mikolajklakulak-bit/Kontroler-lotu/kontroler_lotu.kicad_pcb

## KiCad design kontroler_lotu.kicad_pcb (2026-04-21)

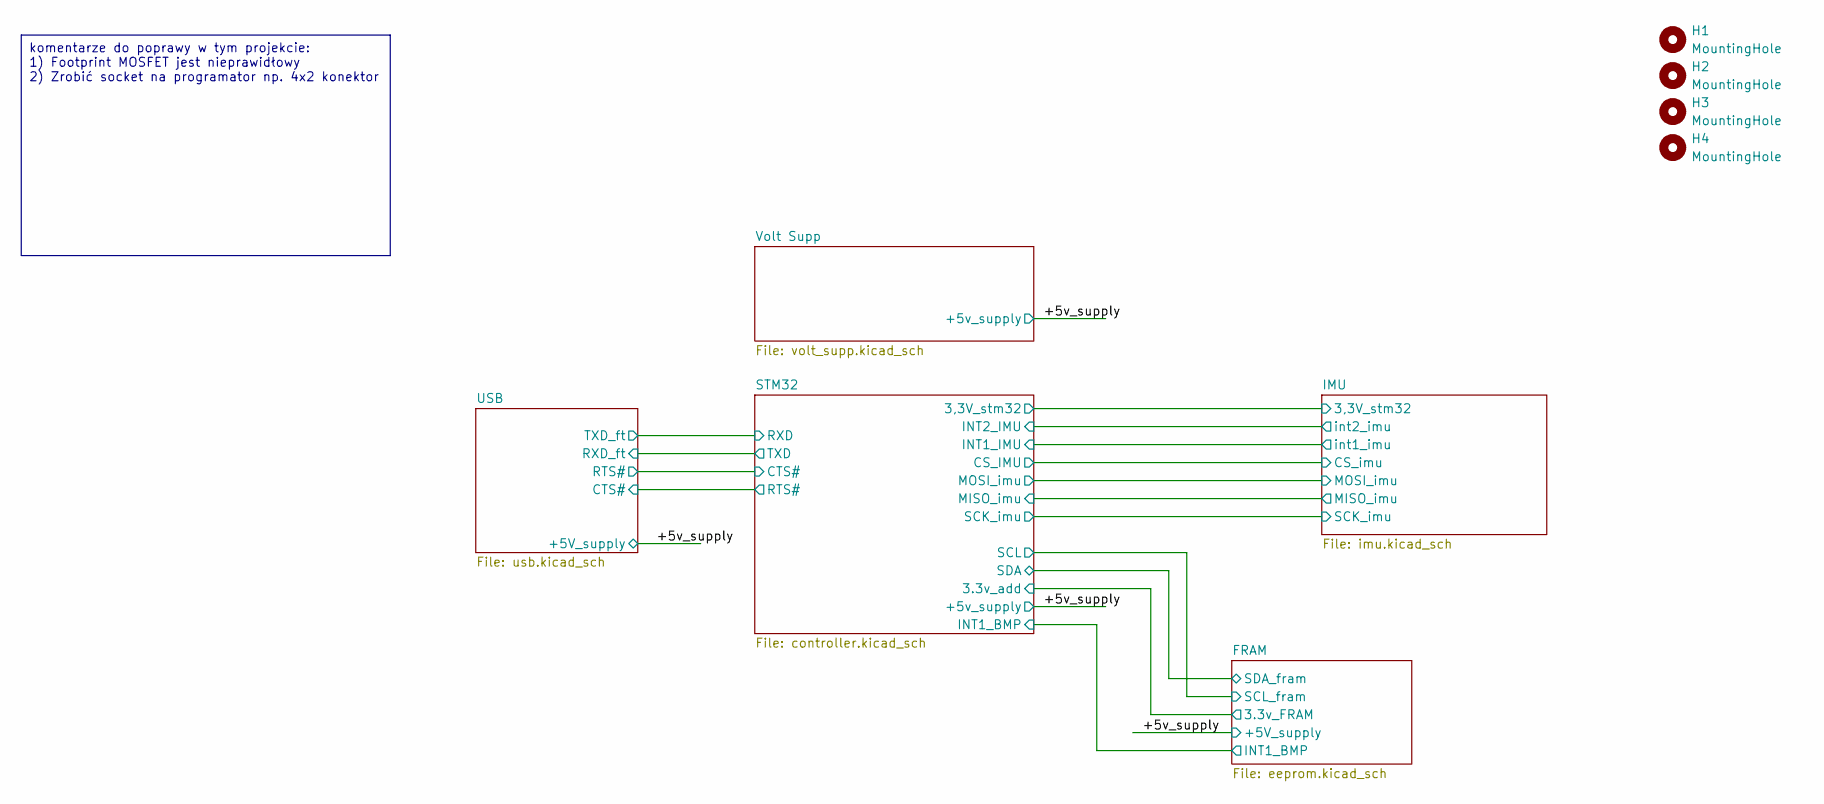
[picture p1: schematic kontroler_lotu.kicad_sch, Kontroler Lotu]

Parts:
H1, H2, H3, H4: MountingHole; MountingHole_3.2mm_M3_Pad

Notes on the sheet:
komentarze do poprawy w tym projekcie: 1) Footprint MOSFET jest nieprawidłowy 2) Zrobić socket na programator np. 4x2 konektor

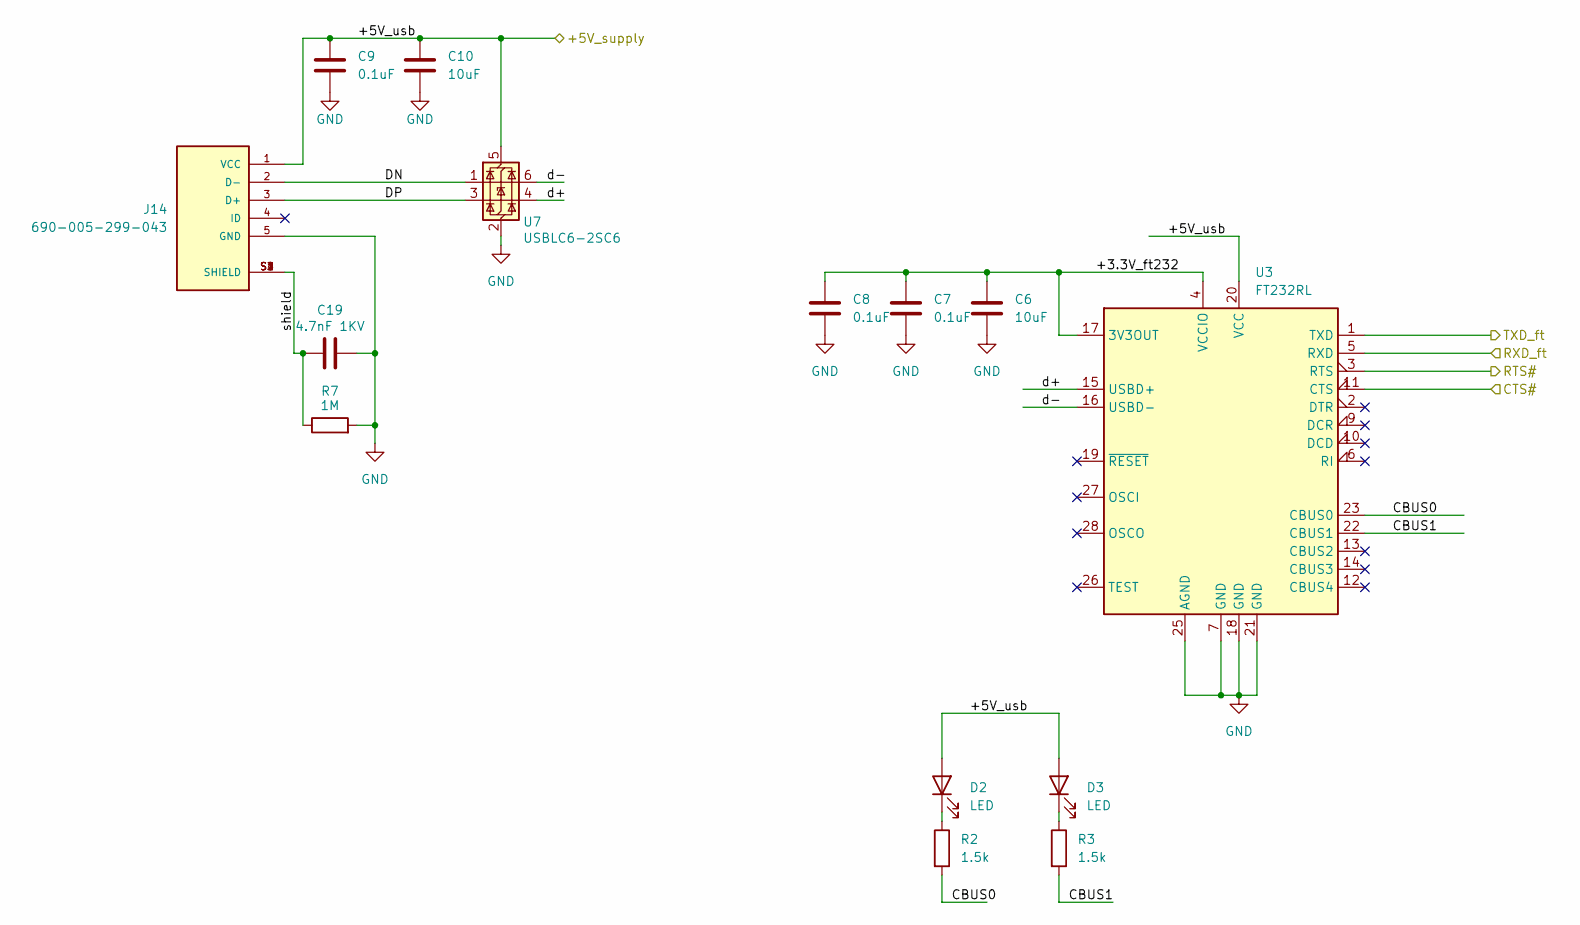
[picture p2: schematic usb.kicad_sch, Kontroler Lotu]

Parts:
C6, C10: 10uF; C_1206_3216Metric
C7, C8, C9: 0.1uF; C_0603_1608Metric
C19: 4.7nF 1KV; C_1210_3225Metric
D2, D3: LED; LED_0805_2012Metric
J14: 690-005-299-043; 690005299043; PARTREV 11; DigiKey_Part_Number 151-1206-2-ND
R2, R3: 1.5k; R_0603_1608Metric
R7: 1M; R_2512_6332Metric
U3: FT232RL; SSOP-28_5.3x10.2mm_P0.65mm
U7: USBLC6-2SC6; SOT-23-6

Connections:
/+5v_supply: C9.1, C10.1, D2.2 (A), D3.2 (A), J14.1 (VCC), U3.20 (VCC), U7.5 (VBUS); also elsewhere on the board
/STM32/CTS#: U3.3 (RTS); also elsewhere on the board
/STM32/RTS#: U3.11 (CTS); also elsewhere on the board
/STM32/RXD: U3.1 (TXD); also elsewhere on the board
/STM32/TXD: U3.5 (RXD); also elsewhere on the board
/USB/+3.3V_ft232: C6.1, C7.1, C8.1, U3.4 (VCCIO), U3.17 (3V3OUT)
/USB/CBUS0: R2.2, U3.23 (CBUS0)
/USB/CBUS1: R3.2, U3.22 (CBUS1)
/USB/DN: J14.2 (D-), U7.1 (I/O1)
/USB/DP: J14.3 (D+), U7.3 (I/O2)
/USB/d+: U3.15 (USBD+), U7.4 (I/O2)
/USB/d-: U3.16 (USBD-), U7.6 (I/O1)
/USB/shield: C19.1, J14.S1 (SHIELD), J14.S2 (SHIELD), J14.S3 (SHIELD), J14.S4 (SHIELD), R7.1
GND: C6.2, C7.2, C8.2, C9.2, C10.2, C19.2, J14.5 (GND), R7.2, U3.7 (GND), U3.18 (GND), U3.21 (GND), U3.25 (AGND), U7.2 (GND); also elsewhere on the board
unnamed: D2.1 (K), R2.1
unnamed: D3.1 (K), R3.1

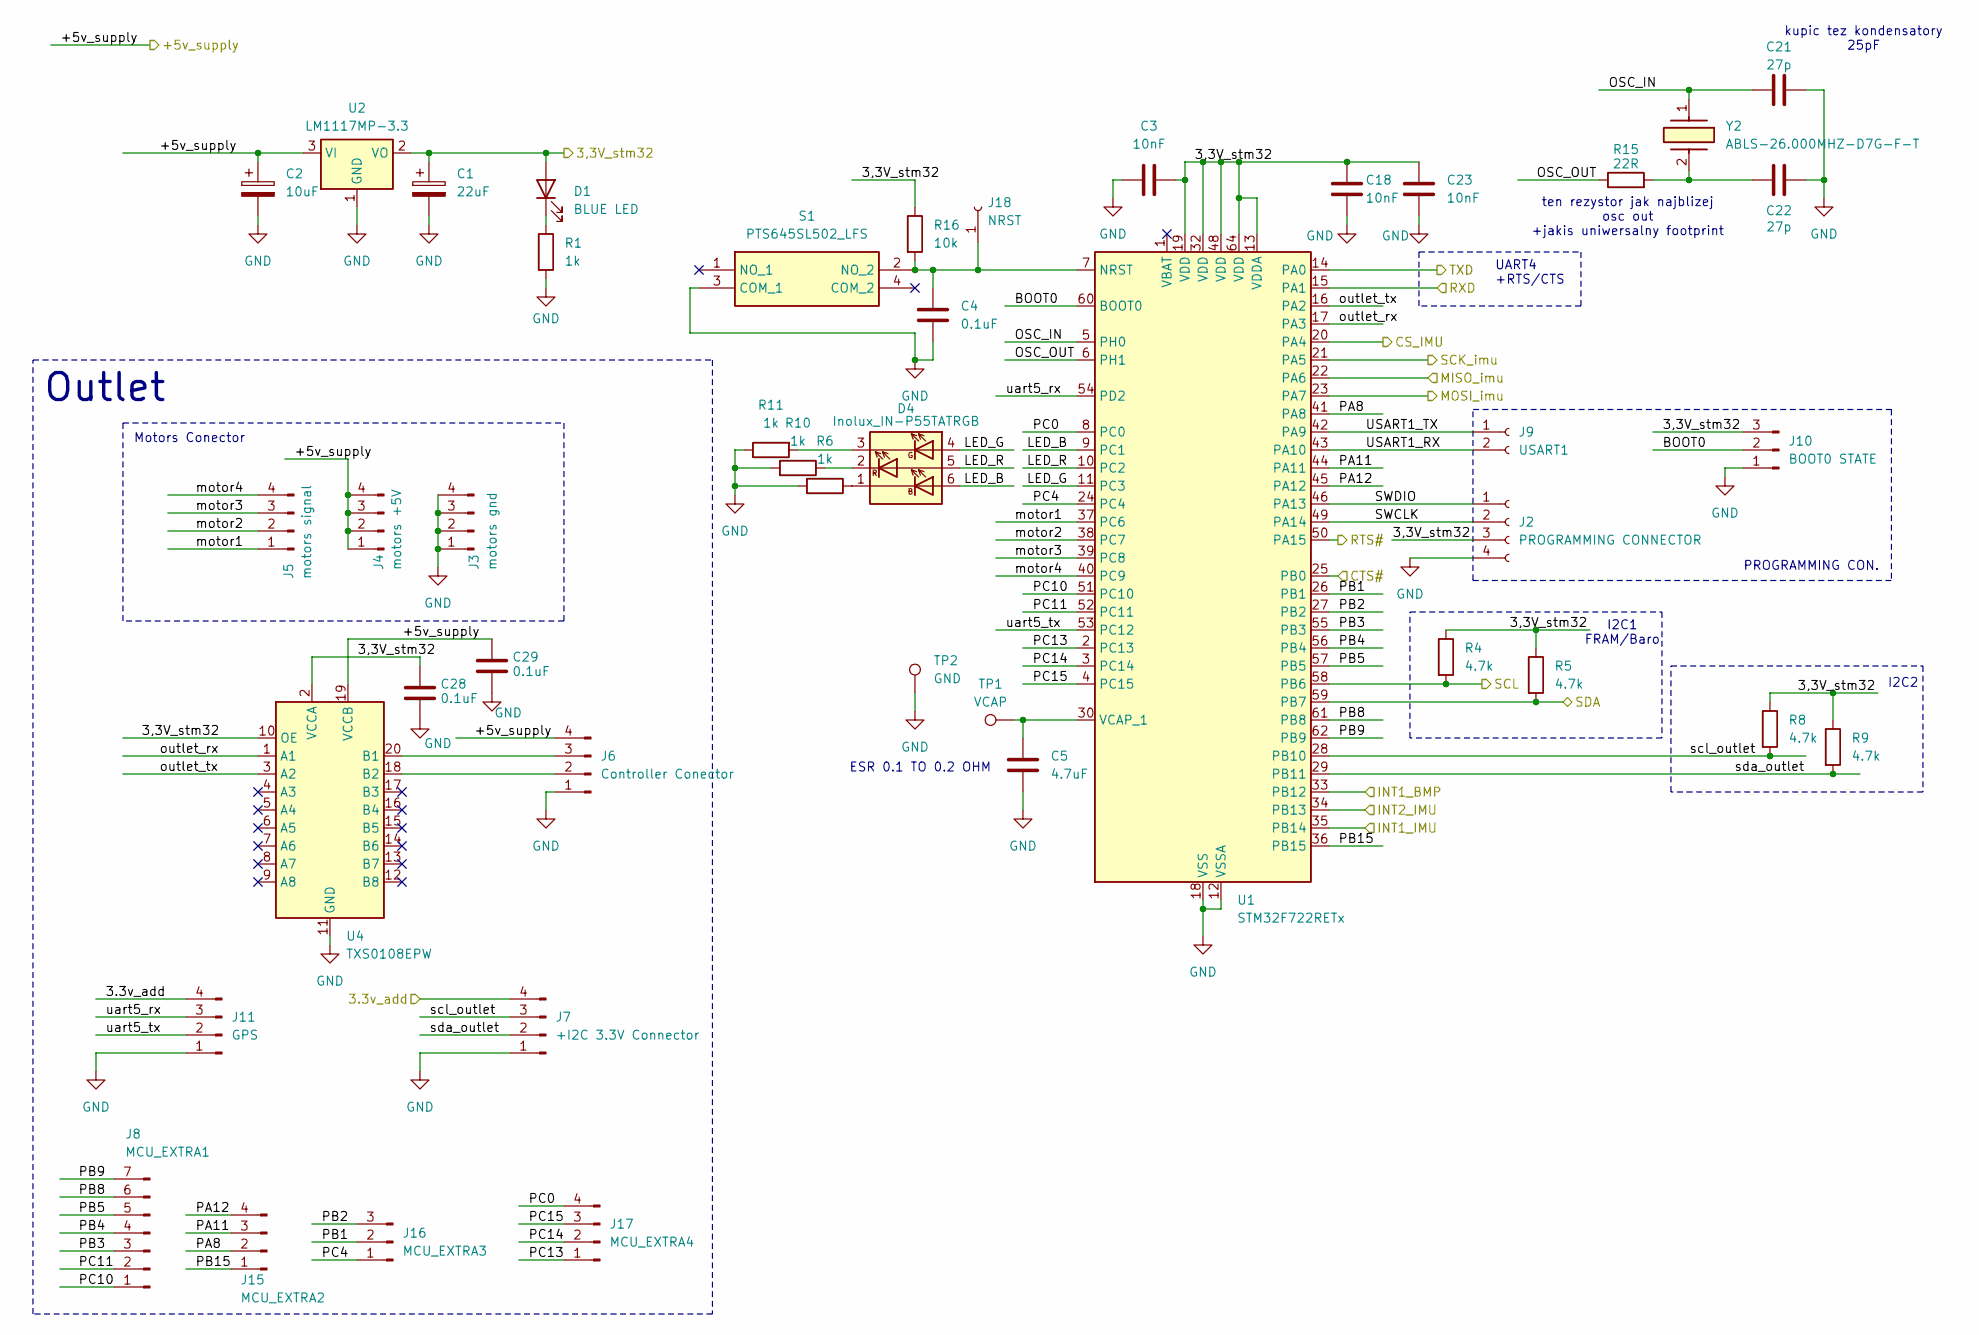
[picture p3: schematic controller.kicad_sch, Kontroler Lotu]

Parts:
C1: 22uF; CP_EIA-3528-12_Kemet-T
C2: 10uF; C_1206_3216Metric
C3, C18, C23: 10nF; C_0603_1608Metric
C4, C28, C29: 0.1uF; C_0603_1608Metric
C5: 4.7uF; C_0603_1608Metric
C21, C22: 27p; C_0603_1608Metric
D1: BLUE LED; LED_0805_2012Metric
D4: Inolux_IN-P55TATRGB; LED_Inolux_IN-P55TATRGB_PLCC6_5.0x5.5mm_P1.8mm
J2: PROGRAMMING CONNECTOR; PinHeader_1x04_P2.54mm_Vertical
J3: motors gnd; PinHeader_1x04_P2.54mm_Vertical
J4: motors +5V; PinHeader_1x04_P2.54mm_Vertical
J5: motors signal; PinHeader_1x04_P2.54mm_Vertical
J6: Controller Conector; PinHeader_1x04_P2.54mm_Vertical
J7: +I2C 3.3V Connector; PinHeader_1x04_P2.54mm_Vertical
J8: MCU_EXTRA1; PinHeader_1x07_P2.54mm_Vertical
J9: USART1; PinHeader_1x02_P2.54mm_Vertical
J10: BOOT0 STATE; PinHeader_1x03_P2.54mm_Vertical
J11: GPS; PinHeader_1x04_P2.54mm_Vertical
J15: MCU_EXTRA2; PinHeader_1x04_P2.54mm_Vertical
J16: MCU_EXTRA3; PinHeader_1x03_P2.54mm_Vertical
J17: MCU_EXTRA4; PinHeader_1x04_P2.54mm_Vertical
J18: NRST; PinHeader_1x01_P2.54mm_Vertical
R1, R6, R10, R11: 1k; R_0603_1608Metric
R4, R5, R8, R9: 4.7k; R_0603_1608Metric
R15: 22R; R_0603_1608Metric
R16: 10k; R_0603_1608Metric
S1: PTS645SL502_LFS; PTS645SL502LFS; Manufacturer_Part_Number PTS645SL502 LFS
TP1: VCAP; TestPoint_Keystone_5015_Micro-Minature
TP2: GND; TestPoint_Keystone_5015_Micro-Minature
U1: STM32F722RETx; LQFP-64_10x10mm_P0.5mm
U2: LM1117MP-3.3; SOT-223-3_TabPin2
U4: TXS0108EPW; TSSOP-20_4.4x6.5mm_P0.65mm
Y2: ABLS-26.000MHZ-D7G-F-T; ABLS; Manufacturer_Part_Number ABLS-26.000MHZ-D7G-F-T

Connections:
/+5v_supply: C2.1, C29.1, J4.1, J4.2, J4.3, J4.4, J6.4, U2.3 (VI), U4.19 (VCCB); also elsewhere on the board
/FRAM/3,3V_fram: J7.4, J11.4; also elsewhere on the board
/FRAM/INT1_BMP: U1.33 (PB12); also elsewhere on the board
/FRAM/SCL_fram: R4.2, U1.58 (PB6); also elsewhere on the board
/FRAM/SDA_fram: R5.2, U1.59 (PB7); also elsewhere on the board
/IMU/3,3V_imu: C1.1, C3.2, C18.2, C23.2, C28.1, D1.2 (A), J2.3, J10.3, R4.1, R5.1, R8.1, R9.1, R16.1, U1.13 (VDDA), U1.19 (VDD), U1.32 (VDD), U1.48 (VDD), U1.64 (VDD), U2.2 (VO), U4.2 (VCCA), U4.10 (OE); also elsewhere on the board
/IMU/CS_imu: U1.20 (PA4); also elsewhere on the board
/IMU/MISO_imu: U1.22 (PA6); also elsewhere on the board
/IMU/MOSI_imu: U1.23 (PA7); also elsewhere on the board
/IMU/SCK_imu: U1.21 (PA5); also elsewhere on the board
/IMU/int1_imu: U1.35 (PB14); also elsewhere on the board
/IMU/int2_imu: U1.34 (PB13); also elsewhere on the board
/STM32/BOOT0: J10.2, U1.60 (BOOT0)
/STM32/CTS#: U1.25 (PB0); also elsewhere on the board
/STM32/LED_B: D4.6 (AB), U1.9 (PC1)
/STM32/LED_G: D4.4 (AG), U1.11 (PC3)
/STM32/LED_R: D4.5 (AR), U1.10 (PC2)
/STM32/OSC_IN: C21.1, U1.5 (PH0), Y2.1
/STM32/OSC_OUT: R15.1, U1.6 (PH1)
/STM32/PA8: J15.2, U1.41 (PA8)
/STM32/PA11: J15.3, U1.44 (PA11)
/STM32/PA12: J15.4, U1.45 (PA12)
/STM32/PB1: J16.2, U1.26 (PB1)
/STM32/PB2: J16.3, U1.27 (PB2)
/STM32/PB3: J8.3, U1.55 (PB3)
/STM32/PB4: J8.4, U1.56 (PB4)
/STM32/PB5: J8.5, U1.57 (PB5)
/STM32/PB8: J8.6, U1.61 (PB8)
/STM32/PB9: J8.7, U1.62 (PB9)
/STM32/PB15: J15.1, U1.36 (PB15)
/STM32/PC0: J17.4, U1.8 (PC0)
/STM32/PC4: J16.1, U1.24 (PC4)
/STM32/PC10: J8.1, U1.51 (PC10)
/STM32/PC11: J8.2, U1.52 (PC11)
/STM32/PC13: J17.1, U1.2 (PC13)
/STM32/PC14: J17.2, U1.3 (PC14)
/STM32/PC15: J17.3, U1.4 (PC15)
/STM32/RTS#: U1.50 (PA15); also elsewhere on the board
/STM32/RXD: U1.15 (PA1); also elsewhere on the board
/STM32/SWCLK: J2.2, U1.49 (PA14)
/STM32/SWDIO: J2.1, U1.46 (PA13)
/STM32/TXD: U1.14 (PA0); also elsewhere on the board
/STM32/USART1_RX: J9.2, U1.43 (PA10)
/STM32/USART1_TX: J9.1, U1.42 (PA9)
/STM32/motor1: J5.1, U1.37 (PC6)
/STM32/motor2: J5.2, U1.38 (PC7)
/STM32/motor3: J5.3, U1.39 (PC8)
/STM32/motor4: J5.4, U1.40 (PC9)
/STM32/outlet_rx: U1.17 (PA3), U4.1 (A1)
/STM32/outlet_tx: U1.16 (PA2), U4.3 (A2)
/STM32/scl_outlet: J7.3, R8.2, U1.28 (PB10)
/STM32/sda_outlet: J7.2, R9.2, U1.29 (PB11)
/STM32/uart5_rx: J11.3, U1.54 (PD2)
/STM32/uart5_tx: J11.2, U1.53 (PC12)
GND: C1.2, C2.2, C3.1, C4.2, C5.2, C18.1, C21.2, C22.2, C23.1, C28.2, C29.2, J2.4, J3.1, J3.2, J3.3, J3.4, J6.1, J7.1, J10.1, J11.1, R1.2, R6.2, R10.2, R11.1, S1.3 (COM_1), TP2.1, U1.12 (VSSA), U1.18 (VSS), U1.31 (VSS), U1.47 (VSS), U1.63 (VSS), U2.1 (GND), U4.11 (GND); also elsewhere on the board
unnamed: C22.1, R15.2, Y2.2
unnamed: D1.1 (K), R1.1
unnamed: D4.1 (KB), R6.1
unnamed: D4.3 (KG), R11.2
unnamed: D4.2 (KR), R10.1
unnamed: J6.2, U4.18 (B2)
unnamed: J6.3, U4.20 (B1)
unnamed: C4.1, J18.1, R16.2, S1.2 (NO_2), U1.7 (NRST)
unnamed: C5.1, TP1.1, U1.30 (VCAP_1)

Notes on the sheet:
UART4 +RTS/CTS
kupic tez kondensatory 25pF
ten rezystor jak najblizej osc out +jakis uniwersalny footprint
Outlet
PROGRAMMING CON.
I2C1 FRAM/Baro
Motors Conector
I2C2
ESR 0.1 TO 0.2 OHM

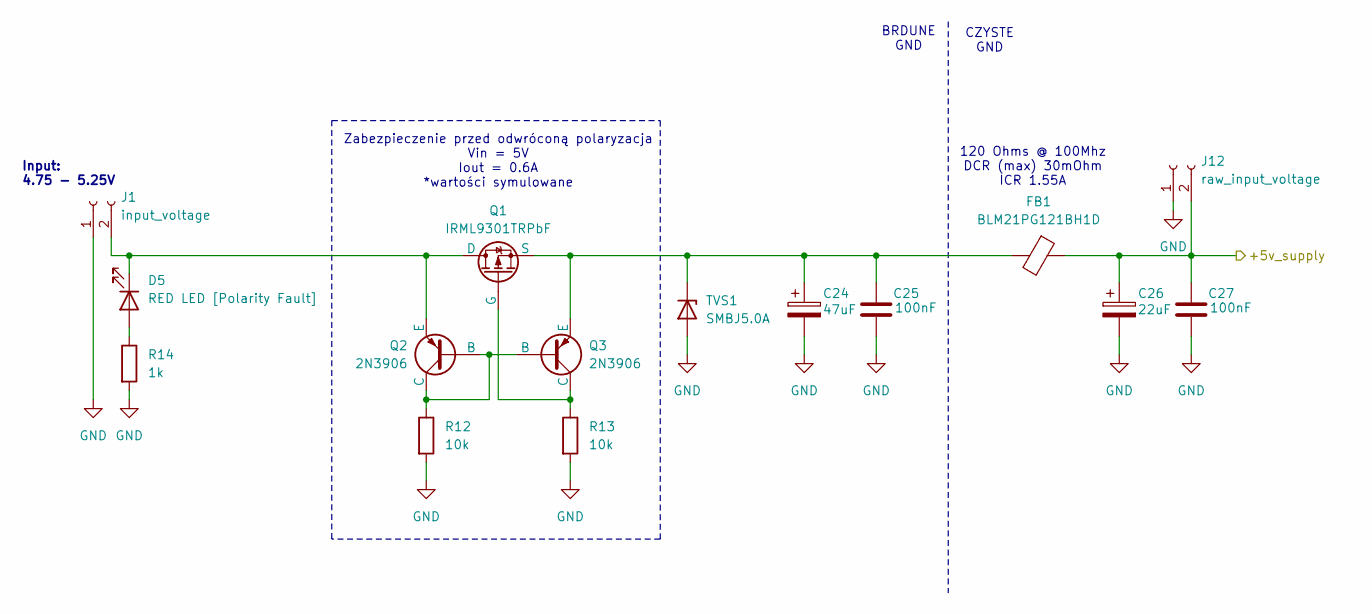
[picture p4: schematic volt_supp.kicad_sch, Kontroler Lotu]

Parts:
C24: 47uF; CP_EIA-3528-12_Kemet-T
C25, C27: 100nF; C_0603_1608Metric
C26: 22uF; CP_EIA-3528-12_Kemet-T
D5: RED LED [Polarity Fault]; LED_0805_2012Metric
FB1: BLM21PG121BH1D; L_0805_2012Metric_Pad1.15x1.40mm_HandSolder
J1: input_voltage; PinSocket_1x02_P2.54mm_Vertical
J12: raw_input_voltage; PinSocket_1x02_P2.54mm_Vertical
Q1: IRML9301TRPbF; SOT-23
Q2, Q3: 2N3906; TO-92L_Inline
R12, R13: 10k; R_0603_1608Metric
R14: 1k; R_0603_1608Metric
TVS1: SMBJ5.0A; D_SMB_Handsoldering

Connections:
/+5v_supply: C26.1, C27.1, FB1.1, J12.2; also elsewhere on the board
GND: C24.2, C25.2, C26.2, C27.2, J1.1, J12.1, R12.2, R13.2, R14.2, TVS1.2 (A); also elsewhere on the board
unnamed: D5.2 (A), R14.1
unnamed: D5.1 (K), J1.2, Q1.1 (D), Q2.3 (E)
unnamed: Q1.2 (G), Q3.1 (C), R13.1
unnamed: C24.1, C25.1, FB1.2, Q1.3 (S), Q3.3 (E), TVS1.1 (K)
unnamed: Q2.1 (C), Q2.2 (B), Q3.2 (B), R12.1

Notes on the sheet:
Zabezpieczenie przed odwróconą polaryzacja Vin = 5V Iout = 0.6A *wartości symulowane
CZYSTE GND
Input: 4.75 - 5.25V
BRDUNE GND
120 Ohms @ 100Mhz DCR (max) 30mOhm ICR 1.55A

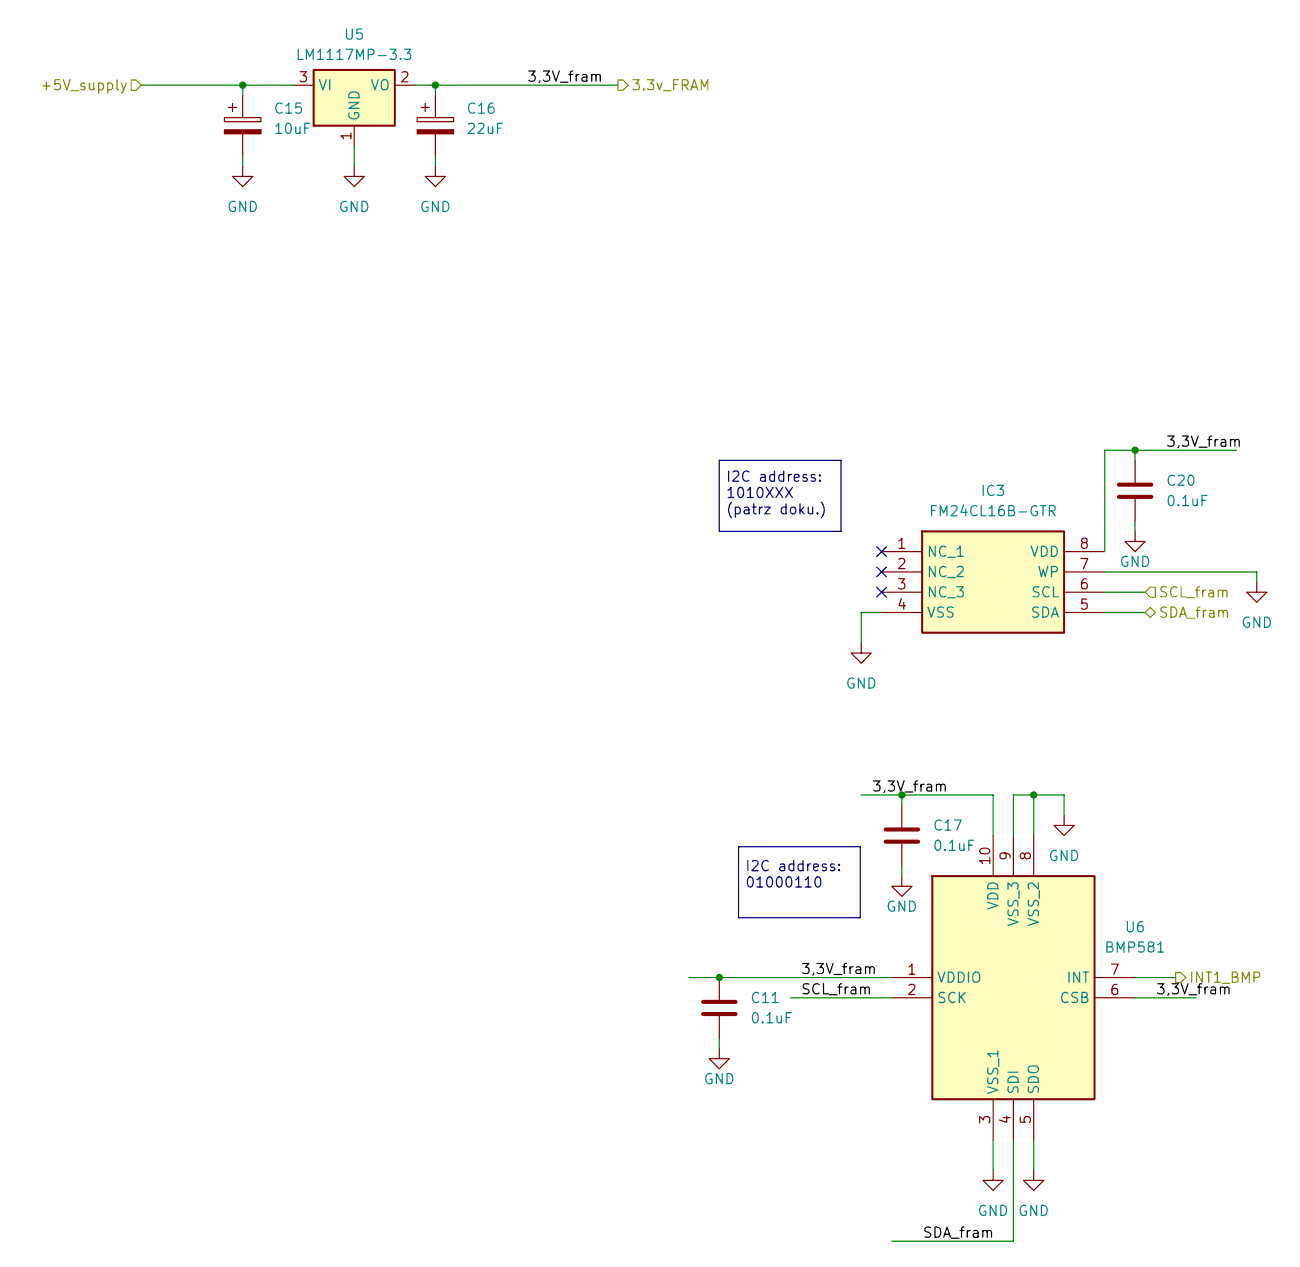
[picture p5: schematic eeprom.kicad_sch, Kontroler Lotu]

Parts:
C11, C17, C20: 0.1uF; C_0603_1608Metric
C15: 10uF; C_1206_3216Metric
C16: 22uF; CP_EIA-3528-12_Kemet-T
IC3: FM24CL16B-GTR; SOIC127P602X173-8N; Manufacturer_Part_Number FM24CL16B-GTR
U5: LM1117MP-3.3; SOT-223-3_TabPin2
U6: BMP581; Mouser Part Number 262-BMP581

Connections:
/+5v_supply: C15.1, U5.3 (VI); also elsewhere on the board
/FRAM/3,3V_fram: C11.1, C16.1, C17.1, C20.1, IC3.8 (VDD), U5.2 (VO), U6.1 (VDDIO), U6.6 (CSB), U6.10 (VDD); also elsewhere on the board
/FRAM/INT1_BMP: U6.7 (INT); also elsewhere on the board
/FRAM/SCL_fram: IC3.6 (SCL), U6.2 (SCK); also elsewhere on the board
/FRAM/SDA_fram: IC3.5 (SDA), U6.4 (SDI); also elsewhere on the board
GND: C11.2, C15.2, C16.2, C17.2, C20.2, IC3.4 (VSS), IC3.7 (WP), U5.1 (GND), U6.3 (VSS_1), U6.5 (SDO), U6.8 (VSS_2), U6.9 (VSS_3); also elsewhere on the board

Notes on the sheet:
I2C address: 01000110
I2C address: 1010XXX (patrz doku.)

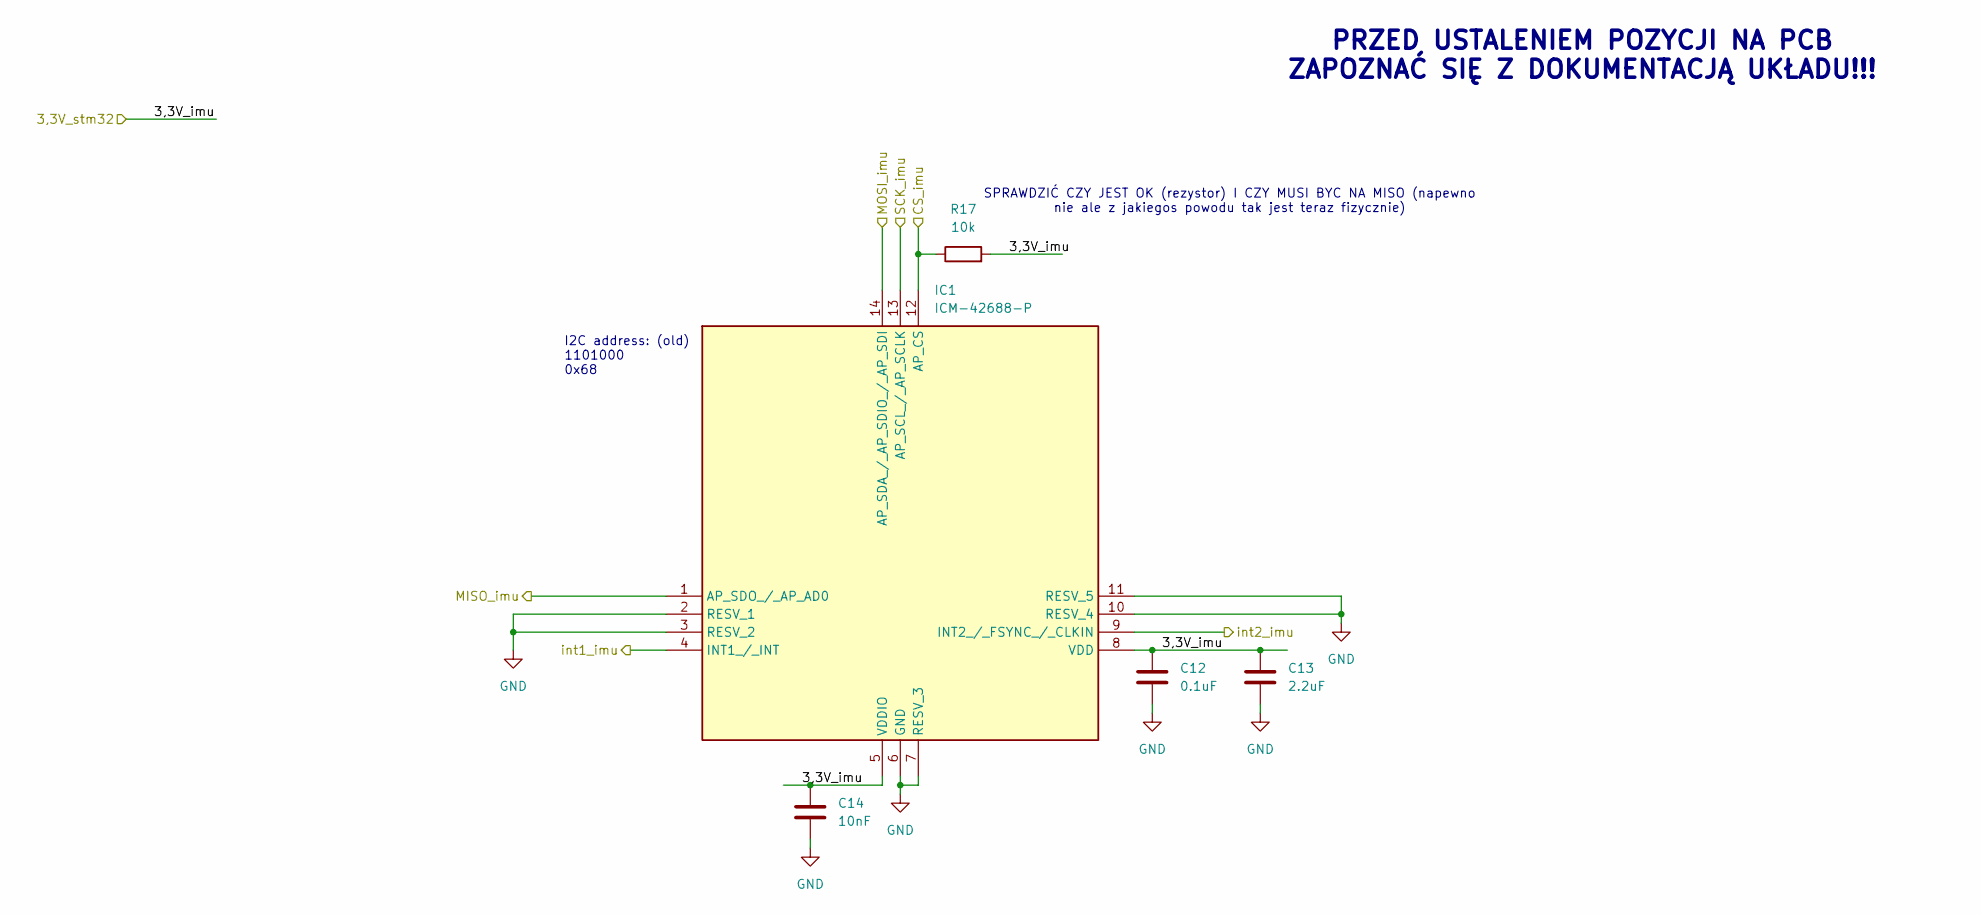
[picture p6: schematic imu.kicad_sch, Kontroler Lotu]

Parts:
C12: 0.1uF; C_0603_1608Metric
C13: 2.2uF; C_1206_3216Metric
C14: 10nF; C_0603_1608Metric
IC1: ICM-42688-P; IIM42352; Mouser Part Number 410-ICM-42688-P
R17: 10k; R_0603_1608Metric

Connections:
/IMU/3,3V_imu: C12.1, C13.1, C14.1, IC1.5 (VDDIO), IC1.8 (VDD), R17.2; also elsewhere on the board
/IMU/CS_imu: IC1.12 (AP_CS), R17.1; also elsewhere on the board
/IMU/MISO_imu: IC1.1 (AP_SDO_/_AP_AD0); also elsewhere on the board
/IMU/MOSI_imu: IC1.14 (AP_SDA_/_AP_SDIO_/_AP_SDI); also elsewhere on the board
/IMU/SCK_imu: IC1.13 (AP_SCL_/_AP_SCLK); also elsewhere on the board
/IMU/int1_imu: IC1.4 (INT1_/_INT); also elsewhere on the board
/IMU/int2_imu: IC1.9 (INT2_/_FSYNC_/_CLKIN); also elsewhere on the board
GND: C12.2, C13.2, C14.2, IC1.2 (RESV_1), IC1.3 (RESV_2), IC1.6 (GND), IC1.7 (RESV_3), IC1.10 (RESV_4), IC1.11 (RESV_5); also elsewhere on the board

Notes on the sheet:
PRZED USTALENIEM POZYCJI NA PCB ZAPOZNAĆ SIĘ Z DOKUMENTACJĄ UKŁADU!!!
SPRAWDZIĆ CZY JEST OK (rezystor) I CZY MUSI BYC NA MISO (napewno nie ale z jakiegos powodu tak jest teraz fizycznie)
I2C address: (old) 1101000 0x68

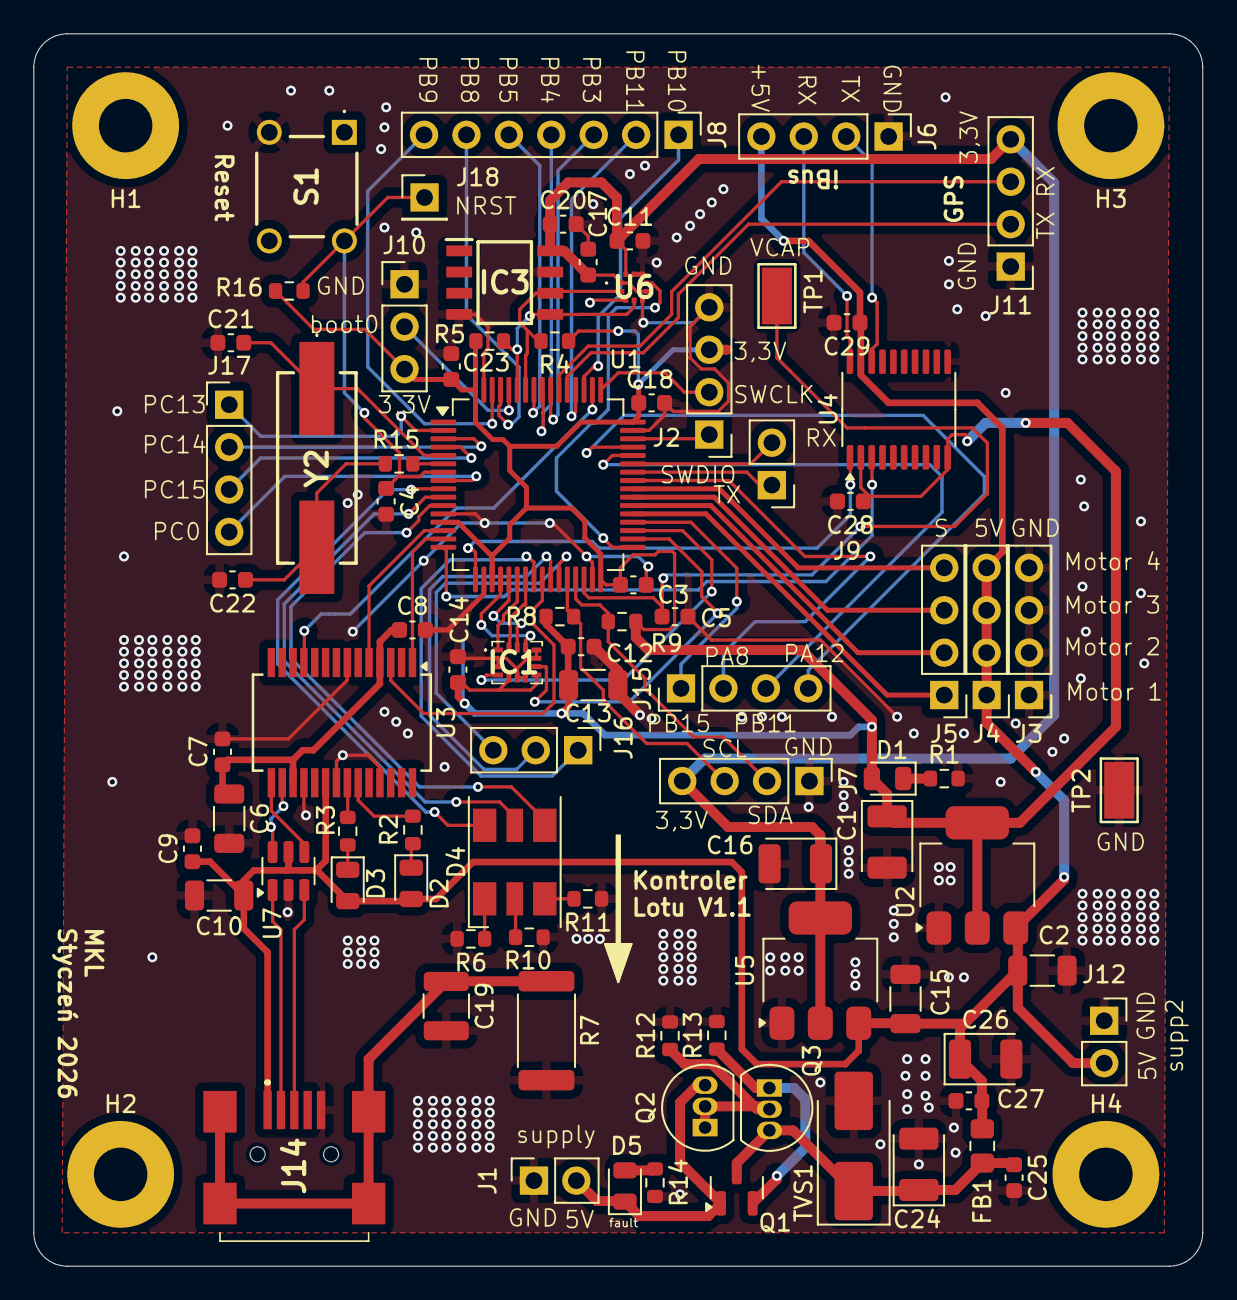
[picture p7: board kontroler_lotu.kicad_pcb from above]

Board: 2 copper layers, 70.0 x 73.8 mm, 90 parts (1 on the bottom side), 79 nets.
