mikolajklakulak-bit/Kontroler-lotu/(commit log)

2026-01-22 PCB pierwszy zrobiony prototyp
    [controller.kicad_sch, eeprom.kicad_sch, imu.kicad_sch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]
2026-01-24 Dodano układ wejściowy dla zasilania. Nie symulowano całości.
    [controller.kicad_sch, kontroler_lotu.kicad_sch, volt_supp.kicad_sch]
2026-01-25 Dodano brakujące footprinty do układu wejściowego i poprawiono SPI - zamieniono SCK <-> MISO (na poprawne)
    [imu.kicad_sch, volt_supp.kicad_sch]
2026-01-26 Zamieniono konwerter napięć na SMD. Zaktualizowano projekt PCB. Usunięto błedy - zostało część ostrzeżeń dotyczących nakładających się silk.
    [controller.kicad_sch, kontroler_lotu.kicad_pcb]
2026-04-21 dodano komentarze do projektu
    [controller.kicad_sch, imu.kicad_sch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]
